practable/ripple-tank/hw/documents/Simple Audio Amplifier Circuit Diagram using TIP41 TIP42 & TLE2141C by TronicPro.jpg

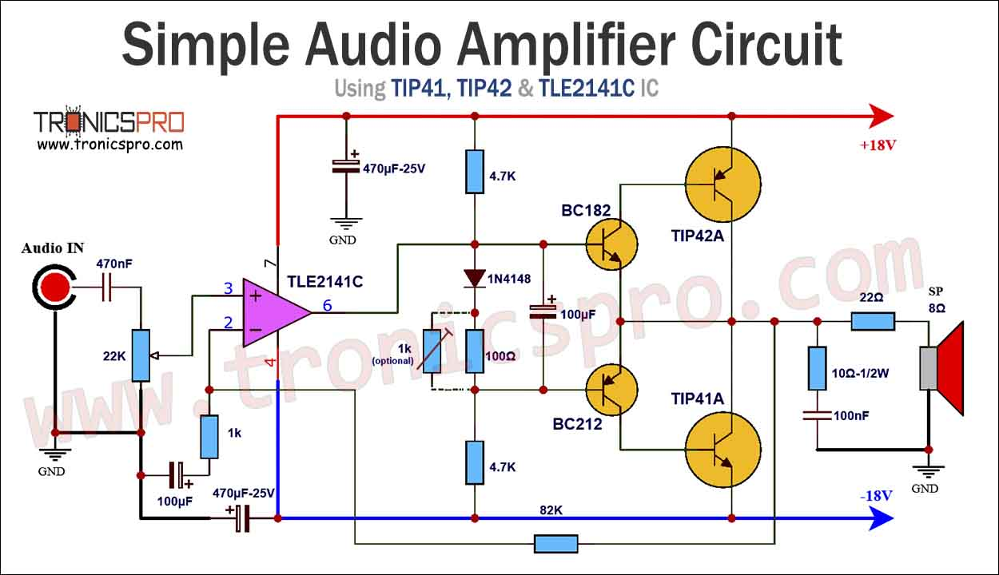
hw/documents/Simple Audio Amplifier Circuit Diagram using TIP41 TIP42 & TLE2141C by TronicPro.jpg
