practable/ripple-tank/README.md

# ripple tank

Ripple tank remote laboratory funded by Royal Academy of Engineering Ingenious grant 2025-26 for high school outreach activities. The ripple tanks automatically maintain water depth by filling from a reservoir and are pre-configured with different setups, including one or two wave sources, various water depths and different optics (reflectors and refractors). The user interface enables control of wave frequency and amplitude and the measurement of wavelength, supporting students to perform in depth investigations of wave properties beyond the typical classroom use of ripple tanks for demonstration and observation of wave behaviours only. 

# Contents

Details of the firmware, hardware and user interface can be found:

- [fw](./fw/README.md)
- [hw](./hw/README.md)
- [ui](./ui/README.md)

# Activities

Example activities can be found [here](./docs/RippleTank_ActivityBooklet_v2.pdf)

# Versions

- v1.1.1: updated responsiveness of video component and cleaned up reconnection logic to stop video flickering bug
- v1.0.0: end of project production release
