practable/ripple-tank/hw/documents/capacative-mosture-sensor.png

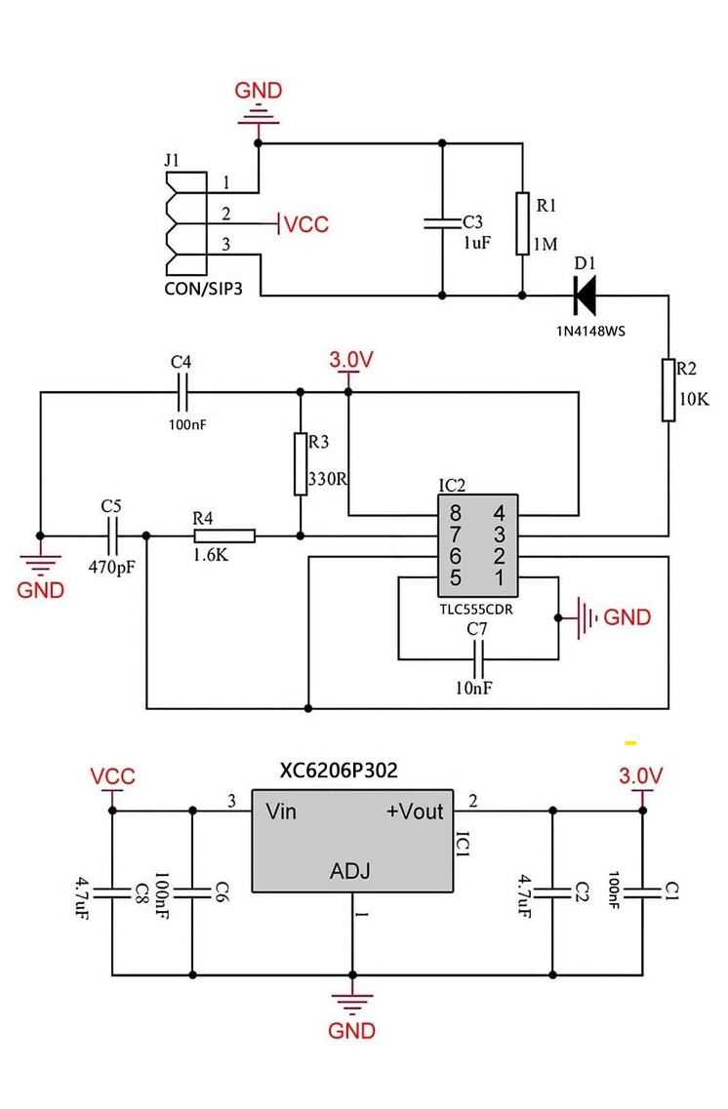
hw/documents/capacative-mosture-sensor.png
