practable/ripple-tank/hw/ripple-tank-pcb/bom-JLCPCB Assembly Order.xls

JLCPCB BOM Tool - BOM Matching
BOM name：bom-JLCPCB Assembly Order.xlsx |  |  | Download Time：2025-11-10 20:41:47 |  |  |  | * Our matching results are updated in real-time, but stock and prices may change. If it's been over 24 hours, please re-match before placing your order.
PCB Assembled Qty：20 |  |  | Est. Total Price：189.0941
Your BOM |  |  |  |  | Matched Parts |  |  |  |  |  |  | Order Information
Top Designator | Bottom Designator | Comment | Footprint | JLCPCB Part # | Matches | Part # | Manufacturer | Footprint | Description | Category | Warning | JLCPCB Part # | Product link | Lib Type | Qty | Source | Total Price ($)
C1,C11,C12,C16 |  | 100nF | 0805 |  | Select by System | CC0805KRX7R9BB104 | YAGEO | 0805 | 100nF 50V X7R ±10% 0805 Multilayer Ceramic Capacitors MLCC - SMD/SMT ROHS | Multilayer Ceramic Capacitors MLCC - SMD/SMT |  | C49678 | https://jlcpcb.com/partdetail/YAGEO-CC0805KRX7R9BB104/C49678 | Basic | 90 | 90 JLCPCB | 0.387
C2,C5,C6,C7 |  | 220pF | 0805 |  | Select by System | CC0805KRX7R9BB221 | YAGEO | 0805 | 220pF 50V X7R ±10% 0805 Multilayer Ceramic Capacitors MLCC - SMD/SMT ROHS | Multilayer Ceramic Capacitors MLCC - SMD/SMT |  | C107145 | https://jlcpcb.com/partdetail/YAGEO-CC0805KRX7R9BB221/C107145 | Basic | 90 | 90 JLCPCB | 0.468
C10,C13,C14,C3,C4,C8,C9 |  | 1uF | 0805 |  | Select by System | CL21B105KBFNNNE | Samsung Electro-Mechanics | 0805 | 1uF 50V X7R ±10% 0805 Multilayer Ceramic Capacitors MLCC - SMD/SMT ROHS | Multilayer Ceramic Capacitors MLCC - SMD/SMT |  | C28323 | https://jlcpcb.com/partdetail/29074-CL21B105KBFNNNE/C28323 | Basic | 150 | 150 JLCPCB | 1.335
C15 |  | 2.2uF | 0805 |  | Select by System | CL21A225KBQNNNE | Samsung Electro-Mechanics | 0805 | 2.2uF 50V X5R ±10% 0805 Multilayer Ceramic Capacitors MLCC - SMD/SMT ROHS | Multilayer Ceramic Capacitors MLCC - SMD/SMT |  | C377773 | https://jlcpcb.com/partdetail/350246-CL21A225KBQNNNE/C377773 | Basic | 28 | 28 JLCPCB | 0.4368
D1 |  | 12v | 0805 |  | Select by Customer | BL-HUF35A-AV-TRB | BrtLed(Bright LED Elec) | 0805 | -40℃~+85℃ 120° 2.2V 20mA 50mW 630nm 645nm 80mcd Red Water Clear 0805 LED Indication - Discrete ROHS | LED Indication - Discrete |  | C94741 | https://jlcpcb.com/partdetail/95940-BL_HUF35A_AVTRB/C94741 | Extended | 28 | 28 JLCPCB | 0.56
D2 |  | BZV55B10-500mA-10v | D_MiniMELF |  | Select by Customer | ZMM10V | YONGYUTAI | LL-34 | 100nA@7.5V 10V 15Ω 500mW 9.4V~10.6V Independent LL-34 Zener Diodes ROHS | Zener Diodes |  | C2891751 | https://jlcpcb.com/partdetail/YONGYUTAI-ZMM10V/C2891751 | Extended | 30 | 30 JLCPCB | 0.231
D3 |  | 5vAudio | 0805 |  | Select by Customer | NCD0805Y1 | Foshan NationStar Optoelectronics | 0805 | -30℃~+85℃ 1.6V~2.6V 130° 180mcd 25mA 585nm~596nm 595nm 65mW Yellow 0805 LED Indication - Discrete ROHS | LED Indication - Discrete | 1.Multiple lines in the BOM have been matched to the same part. Please check if the matching is correct. ; | C84261 | https://jlcpcb.com/partdetail/85430-NCD0805Y1/C84261 | Extended | 50 | 50 JLCPCB | 0.705
D6 |  | LED1 | 0805 |  | Select by Customer | NCD0805Y1 | Foshan NationStar Optoelectronics | 0805 | -30℃~+85℃ 1.6V~2.6V 130° 180mcd 25mA 585nm~596nm 595nm 65mW Yellow 0805 LED Indication - Discrete ROHS | LED Indication - Discrete | 1.The comment (NCD0805Y1) of this part does not match the one (LED1) provided in your BOM. Please confirm; 2.Multiple lines in the BOM have been matched to the same part. Please check if the matching is correct. ; | C84261 | https://jlcpcb.com/partdetail/85430-NCD0805Y1/C84261 | Extended | 50 | 50 JLCPCB | 0.705
D4 |  | 5vMCU | 0805 |  | Select by Customer | APT2012CGCK | Kingbright | 0805 | -40℃~+85℃ 140° 2.1V 20mA 50mcd 570nm 574nm 75mW Green Water Clear 0805 LED Indication - Discrete ROHS | LED Indication - Discrete |  | C5875740 | https://jlcpcb.com/partdetail/Kingbright-APT2012CGCK/C5875740 | Extended | 22 | 22 JLCPCB | 2.5256
D5 |  | 3v3 | 0805 |  | Select by Customer | NCD0805B2 | Foshan NationStar Optoelectronics | 0805 | -30℃~+85℃ 130° 2.5V~3.6V 20mA 465nm 468nm~478nm 55mcd 72mW Blue 0805 LED Indication - Discrete ROHS | LED Indication - Discrete | 1.Multiple lines in the BOM have been matched to the same part. Please check if the matching is correct. ; | C84259 | https://jlcpcb.com/partdetail/85428-NCD0805B2/C84259 | Extended | 48 | 48 JLCPCB | 1.032
D8 |  | LED2 | 0805 |  | Select by Customer | NCD0805B2 | Foshan NationStar Optoelectronics | 0805 | -30℃~+85℃ 130° 2.5V~3.6V 20mA 465nm 468nm~478nm 55mcd 72mW Blue 0805 LED Indication - Discrete ROHS | LED Indication - Discrete | 1.The comment (NCD0805B2) of this part does not match the one (LED2) provided in your BOM. Please confirm; 2.Multiple lines in the BOM have been matched to the same part. Please check if the matching is correct. ; | C84259 | https://jlcpcb.com/partdetail/85428-NCD0805B2/C84259 | Extended | 48 | 48 JLCPCB | 1.032
D7 |  | MBRA340 | D_SMA |  | Select by Customer | MBRA340T3G | onsemi | SMA(DO-214AC) | -55℃~+150℃ 100A 300uA@40V 3A 40V 450mV@3A SMA(DO-214AC) Schottky Diodes ROHS | Schottky Diodes | 1.The comment (MBRA340T3G) of this part does not match the one (MBRA340) provided in your BOM. Please confirm; | C26178 | https://jlcpcb.com/partdetail/onsemi-MBRA340T3G/C26178 | Extended | 20 | 20 JLCPCB | 3.594
D9 |  | 1N5821_equ_SMB | D_SMB_Handsoldering |  | Select by Customer | SS36F | YFW | SMAF | -55℃~+150℃ 3A 500uA@60V 60V 700mV@3A 80A Independent SMAF Schottky Diodes ROHS | Schottky Diodes |  | C2898361 | https://jlcpcb.com/partdetail/YFW-SS36F/C2898361 | Extended | 28 | 28 JLCPCB | 0.8288
EC1,EC7,EC8 |  | 220uF | CP_Elec_10x10 |  | Select by Customer | 50TZV220M10X10.5 | Rubycon | SMD,D10xL10.5mm | -55℃~+105℃ 10.5mm 10mm 2000hrs@105℃ 220uF 402mA@120Hz 50V ±20% SMD,D10xL10.5mm Aluminum Electrolytic Capacitors - SMD ROHS | Aluminum Electrolytic Capacitors - SMD |  | C88818 | https://jlcpcb.com/partdetail/Rubycon-50TZV220M10X105/C88818 | Extended | 60 | 60 JLCPCB | 11.646
EC2,EC3,EC4,EC6,EC9 |  | 220uF | CP_Elec_6.3x7.7 |  | Select by Customer | MVG 16V 220UF 6.3*7.7 | SamYoung Electronics | SMD,D6.3xL7.7mm | -40℃~+85℃ 130mA@120Hz 16V 2000hrs@85℃ 220uF 6.3mm 7.7mm ±20% SMD,D6.3xL7.7mm Aluminum Electrolytic Capacitors - SMD ROHS | Aluminum Electrolytic Capacitors - SMD |  | C2827940 | https://jlcpcb.com/partdetail/2975110-MVG_16V_220UF_6_3_77/C2827940 | Extended | 101 | 101 JLCPCB | 7.8679
EC5 |  | 470uF | CP_Elec_6.3x7.7 |  | Select by Customer | RVT1C471M0810 | Honor Elec | SMD,D8xL10.2mm | -55℃~+105℃ 10.2mm 16V 2000hrs@105℃ 470uF 8mm ±20% SMD,D8xL10.2mm Aluminum Electrolytic Capacitors - SMD ROHS | Aluminum Electrolytic Capacitors - SMD |  | C3341 | https://jlcpcb.com/partdetail/HonorElec-RVT1C471M0810/C3341 | Extended | 21 | 21 JLCPCB | 1.2474
F1 |  | 3.5A | littlefuse-154-nano-block-holster |  | Select by Customer | 0154.062DR | Littelfuse | SMD,9.7x5mm | -55℃~+125℃ 125V 125V 50A 62mA Surface Mount Fuse (with Holder) SMD,9.7x5mm Disposable fuses ROHS | Disposable Fuses |  | C187515 | https://jlcpcb.com/partdetail/Littelfuse-0154062DR/C187515 | Extended | 20 | 20 JLCPCB | 27.33
FB1,FB2,FB3,FB4 |  | FB | 0805 |  | Select by Customer | GZ2012D220TF | Sunlord | 0805 | -55℃~+125℃ 1 22Ω@100MHz ±25% 0805 Ferrite Beads ROHS | Ferrite Beads |  | C1009 | https://jlcpcb.com/partdetail/Sunlord-GZ2012D220TF/C1009 | Extended | 90 | 90 JLCPCB | 0.756
L1,L2 |  | 33uH | L_12x12mm_H8mm |  | Select by System | YPRH1207-330M | YJYCOIN | SMD,12x12mm | 33uH 3A 65mΩ Magnetic Shielded Inductor ±20% SMD,12x12mm Power Inductors ROHS | Power Inductors |  | C339951 | https://jlcpcb.com/partdetail/YJYCOIN-YPRH1207330M/C339951 | Extended | 40 | 40 JLCPCB | 12.056
Q1 |  | IRF5305S_PBF_smd | TO-263-3_TabPin2 |  | Select by Customer | IRF5305SPBF-VB | VBsemi Elec | D2PAK(TO-263) | -55℃~+150℃ 1 P-Channel 1.65nF 120pF 2.5V@250uA 200pF 35A 48mΩ@10V 60V 61W 67nC@10V P-Channel D2PAK(TO-263) MOSFETs ROHS | MOSFETs |  | C5355716 | https://jlcpcb.com/partdetail/VBsemiElec-IRF5305SPBFVB/C5355716 | Extended | 20 | 20 JLCPCB | 10.35
R1 |  | 330r | 0805 |  | Select by Customer | 0805W8F3300T5E | UNI-ROYAL(Uniroyal Elec) | 0805 | -55℃~+155℃ 125mW 150V 330Ω Thick Film Resistor ±1% ±100ppm/℃ 0805 Chip Resistor - Surface Mount ROHS | Chip Resistor - Surface Mount | 1.The comment (0805W8F3300T5E) of this part does not match the one (330r) provided in your BOM. Please confirm; | C17630 | https://jlcpcb.com/partdetail/18318-0805W8F3300T5E/C17630 | Basic | 30 | 30 JLCPCB | 0.057
R2,R5,R6 |  | 4k7 | 0805 |  | Select by Customer | 0805W8F4701T5E | UNI-ROYAL(Uniroyal Elec) | 0805 | -55℃~+155℃ 125mW 150V 4.7kΩ Thick Film Resistor ±1% ±100ppm/℃ 0805 Chip Resistor - Surface Mount ROHS | Chip Resistor - Surface Mount | 1.The comment (0805W8F4701T5E) of this part does not match the one (4k7) provided in your BOM. Please confirm; | C17673 | https://jlcpcb.com/partdetail/18361-0805W8F4701T5E/C17673 | Basic | 66 | 66 JLCPCB | 0.1122
R11,R12,R13,R14,R21,R3,R4 |  | 1k | 0805 |  | Select by Customer | 0805W8F1001T5E | UNI-ROYAL(Uniroyal Elec) | 0805 | -55℃~+155℃ 125mW 150V 1kΩ Thick Film Resistor ±1% ±100ppm/℃ 0805 Chip Resistor - Surface Mount ROHS | Chip Resistor - Surface Mount | 1.The comment (0805W8F1001T5E) of this part does not match the one (1k) provided in your BOM. Please confirm; | C17513 | https://jlcpcb.com/partdetail/18201-0805W8F1001T5E/C17513 | Basic | 150 | 150 JLCPCB | 0.255
R15,R16,R17 |  | 0.3r | 0805 |  | Select by Customer | 0805W8F300LT5E | UNI-ROYAL(Uniroyal Elec) | 0805 | -55℃~+155℃ 125mW 150V 300mΩ Thick Film Resistor ±1% ±800ppm/℃ 0805 Chip Resistor - Surface Mount ROHS | Chip Resistor - Surface Mount | 1.The comment (0805W8F300LT5E) of this part does not match the one (0.3r) provided in your BOM. Please confirm; | C247157 | https://jlcpcb.com/partdetail/244365-0805W8F300LT5E/C247157 | Extended | 70 | 70 JLCPCB | 0.273
R18,R19,R20,R7,R8 |  | 10k | 0805 |  | Select by Customer | 0805W8F1002T5E | UNI-ROYAL(Uniroyal Elec) | 0805 | -55℃~+155℃ 10kΩ 125mW 150V Thick Film Resistor ±1% ±100ppm/℃ 0805 Chip Resistor - Surface Mount ROHS | Chip Resistor - Surface Mount | 1.The comment (0805W8F1002T5E) of this part does not match the one (10k) provided in your BOM. Please confirm; | C17414 | https://jlcpcb.com/partdetail/18102-0805W8F1002T5E/C17414 | Basic | 110 | 110 JLCPCB | 0.198
U1 |  | BME280 | Bosch_LGA-8_2.5x2.5mm_P0.65mm_ClockwisePinNumbering |  | Select by System | BME280 | Bosch Sensortec | LGA-8(2.5x2.5) | -40℃~+85℃ 0%RH~100%RH 1.71V~3.6V 1.8uA 16bit I2C ±0.5℃ ±3%RH LGA-8(2.5x2.5) Temperature and Humidity Sensor ROHS | Temperature And Humidity Sensor |  | C92489 | https://jlcpcb.com/partdetail/BoschSensortec-BME280/C92489 | Extended | 20 | 20 JLCPCB | 52.41
U2 |  | PAM8403 | SO-16_5.3x10.2mm_P1.27mm |  | Select by System | PAM8403 | Slkor(SLKORMICRO Elec.) | SOP-16 | -40℃~+85℃ 2-Channel 2.2V~5.5V 3Wx2@4Ω 6.3mA 90% Class D SOP-16 Audio Amplifiers ROHS | Audio Amplifiers |  | C5122557 | https://jlcpcb.com/partdetail/Slkor_SLKORMICRO_Elec-PAM8403/C5122557 | Extended | 20 | 20 JLCPCB | 4.998
U3 |  | AMS1117-5.0 | SOT-223-3_TabPin2 |  | Select by System | AMS1117-5.0 | Advanced Monolithic Systems | SOT-223 | -40℃~+125℃ 1 1.3V 15V 1A 5V 60dB Fixed Positive SOT-223 Voltage Regulators - Linear, Low Drop Out (LDO) Regulators ROHS | Voltage Regulators - Linear, Low Drop Out (LDO) Regulators |  | C6187 | https://jlcpcb.com/partdetail/Advanced_MonolithicSystems-AMS1117_50/C6187 | Basic | 22 | 22 JLCPCB | 4.0634
U5 |  | AMS1117-3.3 | SOT-223-3_TabPin2 |  | Select by System | AMS1117-3.3 | Advanced Monolithic Systems | SOT-223 | -40℃~+125℃ 0.003%Vout 1 1.1V@(800mA) 16V 1A 3.3V 5mA 72dB@(120Hz) Fixed Over Current Protection Positive SOT-223 Voltage Regulators - Linear, Low Drop Out (LDO) Regulators ROHS | Voltage Regulators - Linear, Low Drop Out (LDO) Regulators |  | C6186 | https://jlcpcb.com/partdetail/Advanced_MonolithicSystems-AMS1117_33/C6186 | Basic | 20 | 20 JLCPCB | 3.282
U7 |  | AL8860 | TSOT-23-5 |  | Select by Customer | AL8860WT-7 | Diodes Incorporated | TSOT-25 | -40℃~+85℃ 1 1A 1MHz 4.5V~40V 5% Analog Buck Built-In DC-DC Short Circuit Protection TSOT-25 LED Drivers ROHS | LED Drivers | 1.The comment (AL8860WT-7) of this part does not match the one (AL8860) provided in your BOM. Please confirm; | C125330 | https://jlcpcb.com/partdetail/DiodesIncorporated-AL8860WT7/C125330 | Extended | 20 | 20 JLCPCB | 4.122
U8 |  | MCP4151-104E-ML | SOIC-8_3.9x4.9mm_P1.27mm |  | Select by Customer | MCP4151-502E/P | Microchip Tech | PDIP-8 | -40℃~+125℃ 1 1.8V~5.5V 1LSB 2.5uA 257 2MHz 50ppm/℃ 5kΩ Linear RAM SPI ±20% PDIP-8 Digital Potentiometers ROHS | Digital Potentiometers |  | C640371 | https://jlcpcb.com/partdetail/MicrochipTech-MCP4151_502EP/C640371 | Extended | 20 | 20 JLCPCB | 24.54
U10 |  | LM2596S-5 | TO-263-5_TabPin3 |  | Select by Customer | LM2596S-5.0 | TWGMC | TO-263-5 | -40℃~+125℃ 1 150kHz 3A 5V 5mA 7V~40V Buck Buck Built-In Fixed TO-263-5 DC-DC Converters ROHS | Voltage Regulators - Linear, Low Drop Out (LDO) Regulators |  | C5276750 | https://jlcpcb.com/partdetail/TWGMC-LM2596S_50/C5276750 | Extended | 20 | 20 JLCPCB | 9.69
A1 |  | Arduino_Nano_IoT33 | Arduino_Nano |  | No matches | No Part Selected
A2 |  | DRV8825StepperDriver | DRV8825StepperMotorModule |  | No matches | No Part Selected
J1 |  | XT60_60A_male | AMASS_XT60PW-M_1x02_P7.20mm_Horizontal |  | No matches | No Part Selected
J7 |  | WaveGenerator | TerminalBlock_medium_5.008mm |  | No matches | No Part Selected
J8 |  | LED660mA | TerminalBlock_medium_5.008mm |  | No matches | No Part Selected
J9 |  | 12vPowerIn | TerminalBlock_medium_5.008mm |  | No matches | No Part Selected
J10 |  | Pump | TerminalBlock_Phoenix_MKDS-1,5-4-5.08_1x04_P5.08mm_Horizontal |  | No matches | No Part Selected
J14 |  | MoistureSensor | TerminalBlock_01_03_medium_5.008mm |  | No matches | No Part Selected
PT1 |  | 10k | Potentiometer_Bourns-pot |  | No matches | No Part Selected
U6 |  | femtoBuck_LED_driver | femtoBuck |  | No matches | No Part Selected
