practable/ripple-tank/fw/ripple-tank-fw-V1.x.x/tables.h

/*  This Header defines all the wavetables used to generate the output waveforms
  

  - Wavetables should be offset from 0 to give any buffers headroom.

   Suggested Minimum Value: 600
   Suggested Maximum Value: 1023 

   Suggested number of samples will be dependent on frequency, this is a balance of signal resolution, and required sample rate to produce at the requested frequency.
   A dynamic solution could also be used, however this method is faster to implement with little overhead costless RAM overhead cost (probably)

*/

#pragma once



// Low Frequency, high resolution
const uint16_t sineTable_low[240] PROGMEM = {
  812, 817, 823, 828, 834, 839, 845, 850,
  855, 861, 866, 872, 877, 882, 887, 892,
  898, 903, 908, 912, 917, 922, 927, 931,
  936, 940, 945, 949, 953, 957, 961, 965,
  969, 972, 976, 979, 983, 986, 989, 992,
  995, 997, 1000, 1002, 1005, 1007, 1009, 1011,
  1013, 1014, 1016, 1017, 1018, 1019, 1020, 1021,
  1022, 1022, 1023, 1023, 1023, 1023, 1023, 1022,
  1022, 1021, 1020, 1019, 1018, 1017, 1016, 1014,
  1013, 1011, 1009, 1007, 1005, 1002, 1000, 997,
  995, 992, 989, 986, 983, 979, 976, 972,
  969, 965, 961, 957, 953, 949, 945, 940,
  936, 931, 927, 922, 917, 912, 908, 903,
  898, 892, 887, 882, 877, 872, 866, 861,
  855, 850, 845, 839, 834, 828, 823, 817,
  812, 806, 800, 795, 789, 784, 778, 773,
  768, 762, 757, 751, 746, 741, 736, 731,
  725, 720, 715, 711, 706, 701, 696, 692,
  687, 683, 678, 674, 670, 666, 662, 658,
  654, 651, 647, 644, 640, 637, 634, 631,
  628, 626, 623, 621, 618, 616, 614, 612,
  610, 609, 607, 606, 605, 604, 603, 602,
  601, 601, 600, 600, 600, 600, 600, 601,
  601, 602, 603, 604, 605, 606, 607, 609,
  610, 612, 614, 616, 618, 621, 623, 626,
  628, 631, 634, 637, 640, 644, 647, 651,
  654, 658, 662, 666, 670, 674, 678, 683,
  687, 692, 696, 701, 706, 711, 715, 720,
  725, 731, 736, 741, 746, 751, 757, 762,
  768, 773, 778, 784, 789, 795, 800, 806
};


// Mid Frequency, Mid resolution
const uint16_t sineTable_mid[120] PROGMEM = {
  812, 823, 834, 845, 855, 866, 877, 887,
  898, 908, 917, 927, 936, 945, 953, 961,
  969, 976, 983, 989, 995, 1000, 1005, 1009,
  1013, 1016, 1018, 1020, 1022, 1023, 1023, 1023,
  1022, 1020, 1018, 1016, 1013, 1009, 1005, 1000,
  995, 989, 983, 976, 969, 961, 953, 945,
  936, 927, 917, 908, 898, 887, 877, 866,
  855, 845, 834, 823, 812, 800, 789, 778,
  768, 757, 746, 736, 725, 715, 706, 696,
  687, 678, 670, 662, 654, 647, 640, 634,
  628, 623, 618, 614, 610, 607, 605, 603,
  601, 600, 600, 600, 601, 603, 605, 607,
  610, 614, 618, 623, 628, 634, 640, 647,
  654, 662, 670, 678, 687, 696, 706, 715,
  725, 736, 746, 757, 768, 778, 789, 800
};

// High Frequency, Low resolution
const uint16_t sineTable_high[60] PROGMEM = {
  812, 834, 855, 877, 898, 917, 936, 953,
  969, 983, 995, 1005, 1013, 1018, 1022, 1023,
  1022, 1018, 1013, 1005, 995, 983, 969, 953,
  936, 917, 898, 877, 855, 834, 812, 789,
  768, 746, 725, 706, 687, 670, 654, 640,
  628, 618, 610, 605, 601, 600, 601, 605,
  610, 618, 628, 640, 654, 670, 687, 706,
  725, 746, 768, 789
};



const uint16_t sineTable_Vhigh[30] PROGMEM = {
  812,  855,  898,  936,  969,  995,  1013,  1022,
  1022,  1013,  995,  969,  936,  898,  855,  812,
  768,  725,  687,  654,  628,  610,  601,  601,
  610,  628,  654,  687,  725,  768,  
  };

const uint16_t sineTable_Uhigh[15] PROGMEM = {
812, 898, 969, 1013, 1022, 995, 936, 855,
768, 687, 628, 601, 610, 654, 725 
  };
