practable/ripple-tank/(commit log)

2025-09-24 working on PCB
    [ripple-tank-pcb.kicad_pcb, ripple-tank-pcb.kicad_sch]
2025-09-30 prototype firmware completed, electronic design progressing
2025-09-30 workin on the PCB
    [ripple-tank-pcb.kicad_sch]
2025-10-03 tidied up help function and readme with correct commands
    [stateConfig.h]
2025-11-03 updated schematic to add stepper pump driver
    [ripple-tank-pcb.kicad_sch]
2025-11-03 updated files
    [ripple-tank-pcb.kicad_sch]
2025-11-04 working on PCB design
    [ripple-tank-pcb.kicad_pcb, ripple-tank-pcb.kicad_sch]
2025-11-05 updated PCB
    [ripple-tank-pcb.kicad_pcb, ripple-tank-pcb.kicad_sch]
2025-11-06 fw/ripple_tank_fw_V0_x_x_PWM_Update/ (add): add a modified version of the firmware that updates the frequency of PWM to remove effect of low frequency PWM on lamp LED viewed through webcam
2025-11-06 finished power supply?
    [ripple-tank-pcb.kicad_pcb, ripple-tank-pcb.kicad_sch]
2025-11-07 updated PCB - DRC checks
    [ripple-tank-pcb.kicad_pcb]
2025-11-07 PCB design Finished
    [bom.csv, designators.csv, positions.csv, ripple-tank-pcb.kicad_pcb]
2025-11-07 small PCB revision - added i2c header
    [bom.csv, designators.csv, ripple-tank-pcb.kicad_pcb, ripple-tank-pcb.kicad_sch]
2025-11-10 PCB design finished V1
    [bom-JLCPCB Assembly Order.xls, bom.csv, designators.csv, positions.csv, ripple-tank-pcb.kicad_pcb, ripple-tank-pcb.kicad_sch]
2025-11-11 finished V1.1 PCB
    [V1.1-bom-JLCPCB Assembly Order.xls, bom-JLCPCB Assembly Order.xls, bom.csv, designators.csv, positions.csv, ripple-tank-pcb.kicad_pcb, ripple-tank-pcb.kicad_sch]
2026-01-14 ensuring up to date
    [V1.1-bom-JLCPCB Assembly Order.xls]
2026-01-14 Update BOM section title in README.md
2026-01-19 updating before starting FW dev
    [ripple-tank-pcb.kicad_sch]
2026-01-20 enviro-sensor working and JSON output built
    - however time taken to print JSON report is messing up wavetable output. Going to push this, then change branches to test an interrupt driven wavetable
2026-01-20 working on the pump functioned
2026-01-21 FW V1.0.0 includes multiple table sources and LED PWM modifications
2026-01-22 ahhhh sine wave not sineing correctly
    [cmds.h, globals.h, jsonConfig.h, lamp.h, ripple-tank-fw-V1.x.x.ino, states.h, wavetables.h]
2026-01-22 fixed the sine output issue
    [globals.h, ripple-tank-fw-V1.x.x.ino, ripple_tank_fw_V0_x_x_PWM_Update.ino, states.h, tables.h, wavetables.h]
2026-01-29 Workspace (feat): add markers and update control of ruler and protractor as separate components. Also add a toggle interactivity of workspace button
2026-02-05 commandStore (fix): update lamp command to light instead to conform with latest firmware. Add pump and unpump commands, but not yet implemented in interface
2026-02-05 commandStore (feat): add stop pump command
2026-02-06 updating to current working version
2026-02-06 ui/maintenance (add): new version of user interface that includes pumping water from reservoir functionality
2026-02-06 pump interrupt is working
2026-02-06 ui/default (fix): minor updates: ruler tool has buttons for larger changes in size. ControlPanel no longer displays the possibility of changing the time a pulse happens for
2026-02-09 layout (fix): minor updates to layout and removal of separate download image button in toolbar of video element
2026-02-12 ControlPanel (fix): reducing max amplitude meant that buttons were not changing by 1%, so have fixed
2026-02-20 Workspace (fix): updated layout of ruler and protractor control buttons to stop them overlapping. When workspace is toggled it now goes completely transparent instead of 0.5
2026-02-20 Workspace (fix): changed justification of ruler control tools so that on small screens the overflow scroll shows all the buttons
2026-02-20 ControlPanel (fix): entering pulse mode now fixes the frequency to 24Hz and can only run at that frequency
2026-06-05 ui/default/Workspace (feat): ruler and protractor control buttons now fixed to top of screen
